awnimejri/Self-Balancing-Robot/Conception mécanique/wheel/Wheel/Wheel.JPG

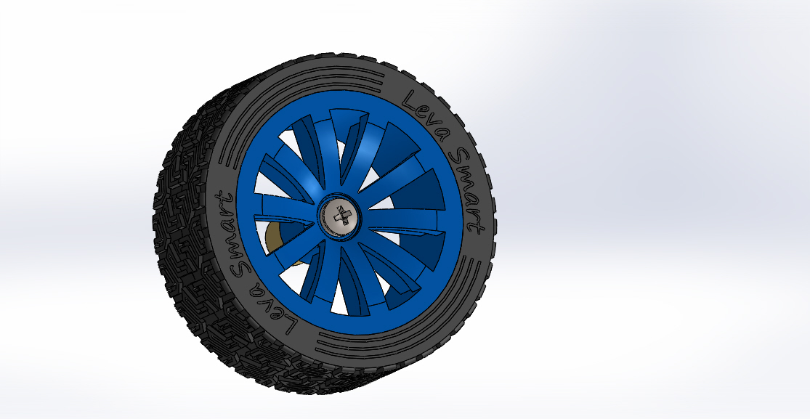
Conception mécanique/wheel/Wheel/Wheel.JPG
