awnimejri/Self-Balancing-Robot/Conception mécanique/wheel/Wheel/Tire.JPG

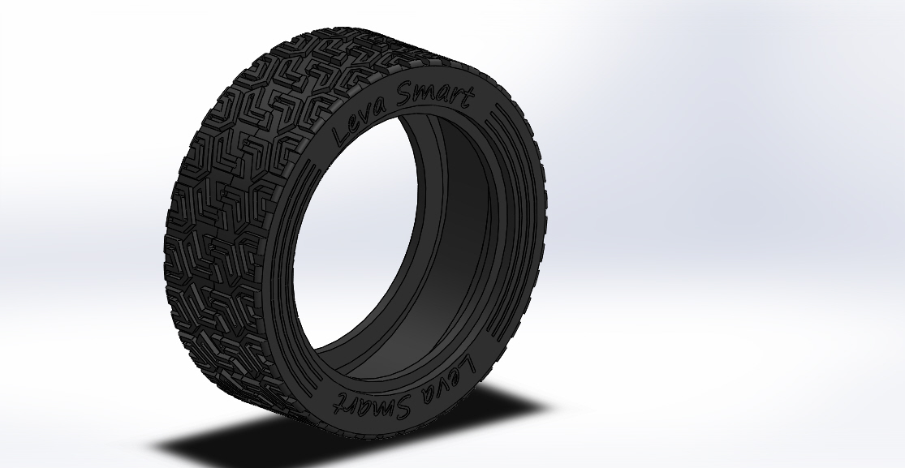
Conception mécanique/wheel/Wheel/Tire.JPG
