awnimejri/Self-Balancing-Robot/Conception électrique/pdf mirrored.pdf

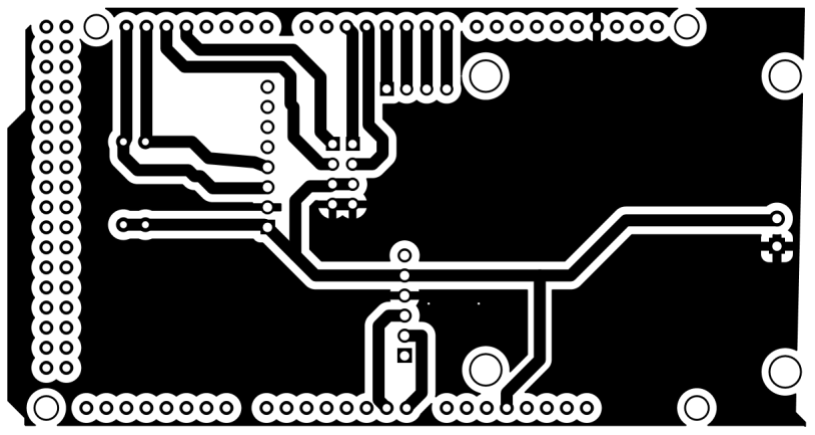
[picture p33: figure]
