awnimejri/Self-Balancing-Robot/Conception électrique/pdf.pdf

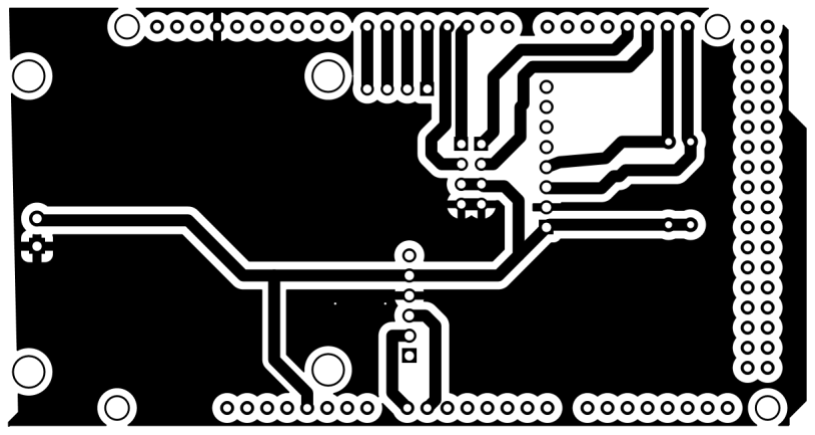
[picture p34: figure]
