awnimejri/Self-Balancing-Robot/Conception mécanique/entretoise/Hexagonal Spacer M3 MF.JPG

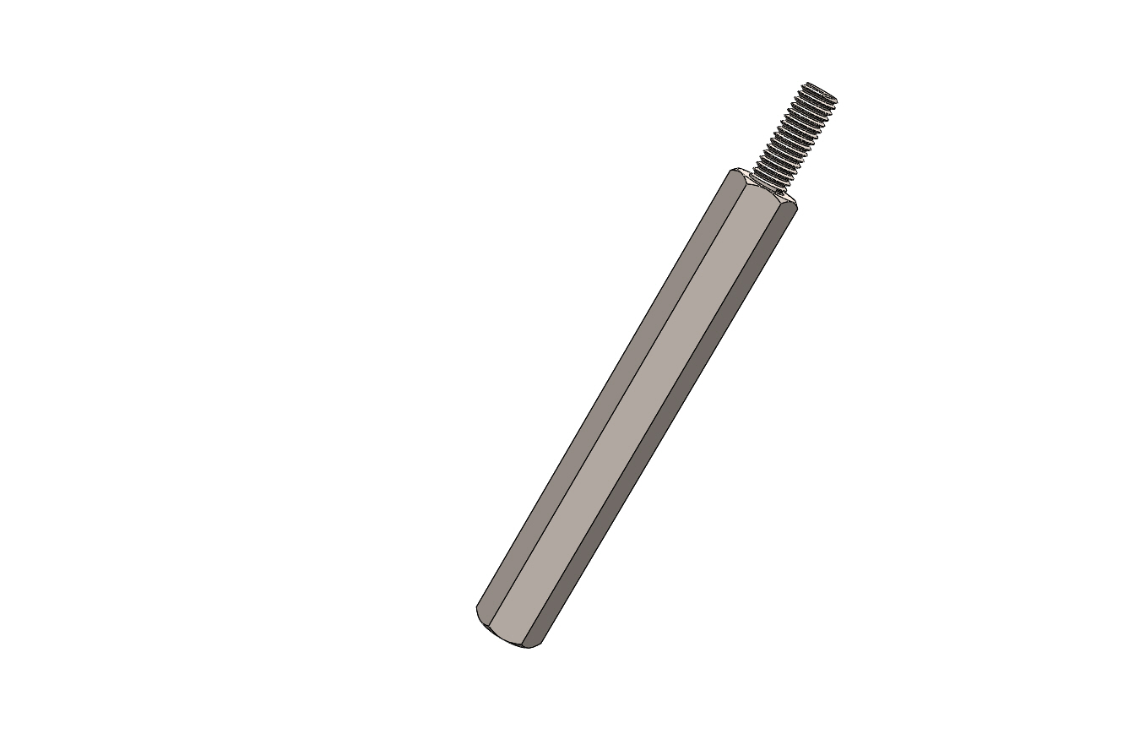
Conception mécanique/entretoise/Hexagonal Spacer M3 MF.JPG
