awnimejri/Self-Balancing-Robot/Conception mécanique/Self_balancing_robot_rendered1.JPG

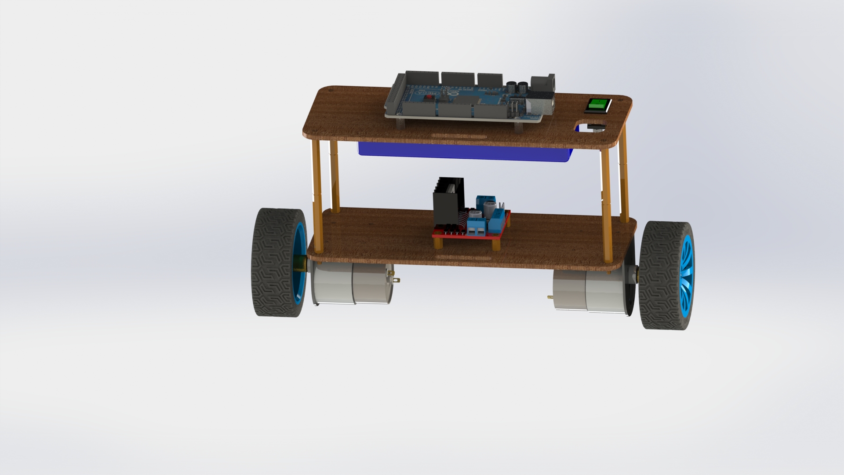
Conception mécanique/Self_balancing_robot_rendered1.JPG
