awnimejri/Self-Balancing-Robot/Conception mécanique/Self_balancing_robot_rendered2.JPG

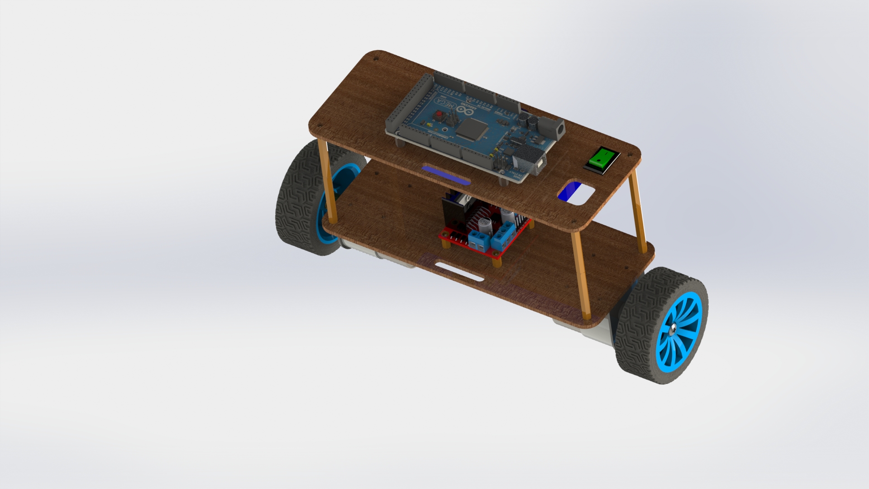
Conception mécanique/Self_balancing_robot_rendered2.JPG
