awnimejri/Self-Balancing-Robot/Conception mécanique/switch/KCD1 Switch v2 1.png

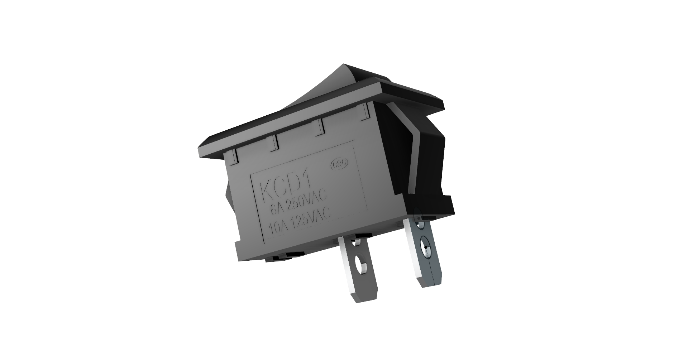
Conception mécanique/switch/KCD1 Switch v2 1.png
