awnimejri/Self-Balancing-Robot/Conception mécanique/switch/KCD1 Switch v2 2.png

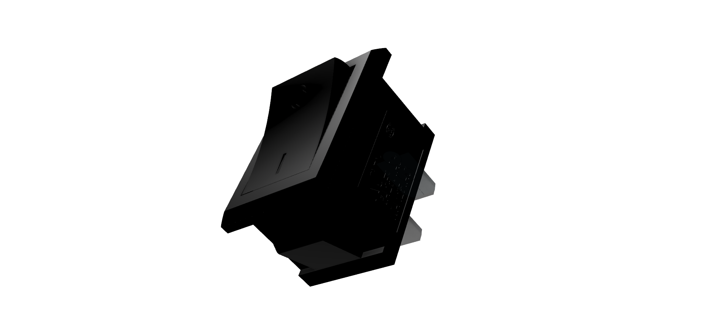
Conception mécanique/switch/KCD1 Switch v2 2.png
