awnimejri/Self-Balancing-Robot/Conception mécanique/wheel/Wheel/Rim.JPG

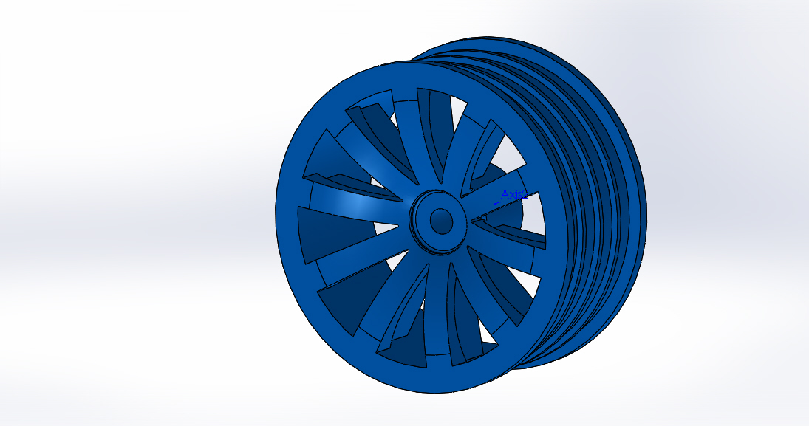
Conception mécanique/wheel/Wheel/Rim.JPG
