awnimejri/Self-Balancing-Robot/Conception électrique/3D view.PNG

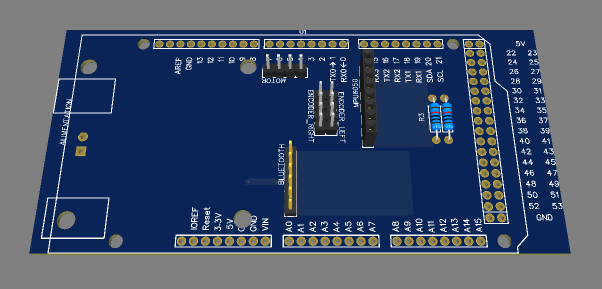
Conception électrique/3D view.PNG
