awnimejri/Self-Balancing-Robot/Conception électrique/PCB_PCB_Self_Balancing_Robot_2022-04-01.png

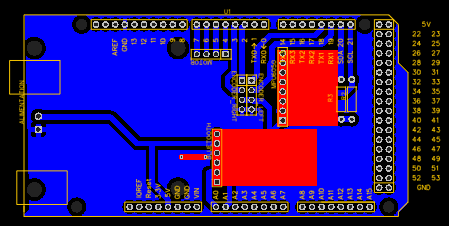
Conception électrique/PCB_PCB_Self_Balancing_Robot_2022-04-01.png
