awnimejri/Self-Balancing-Robot/Conception électrique/Schematic_Self_Balancing_Robot_2022-04-01.png

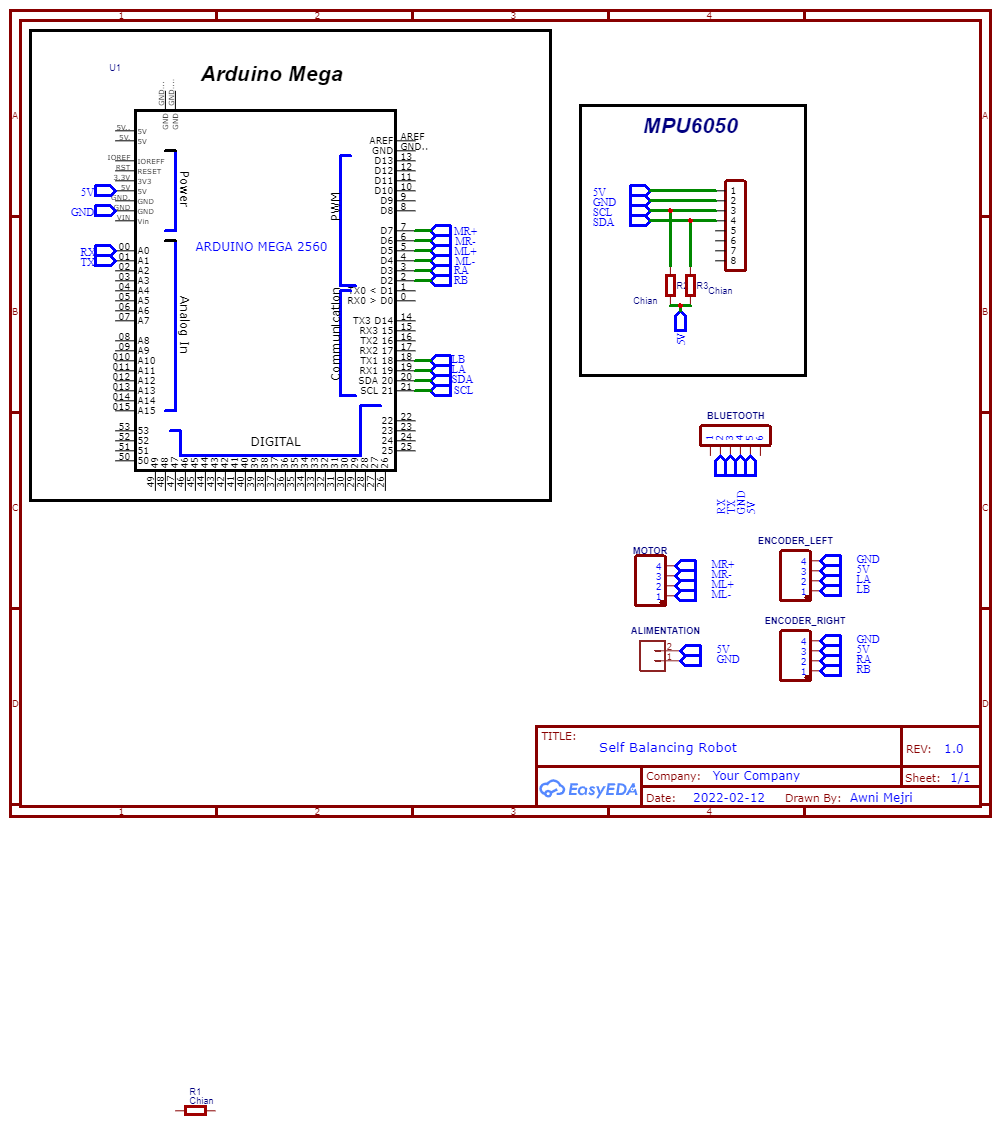
Conception électrique/Schematic_Self_Balancing_Robot_2022-04-01.png
