awnimejri/Self-Balancing-Robot/Conception mécanique/wheel/Wheel/Wheel.SLDASM

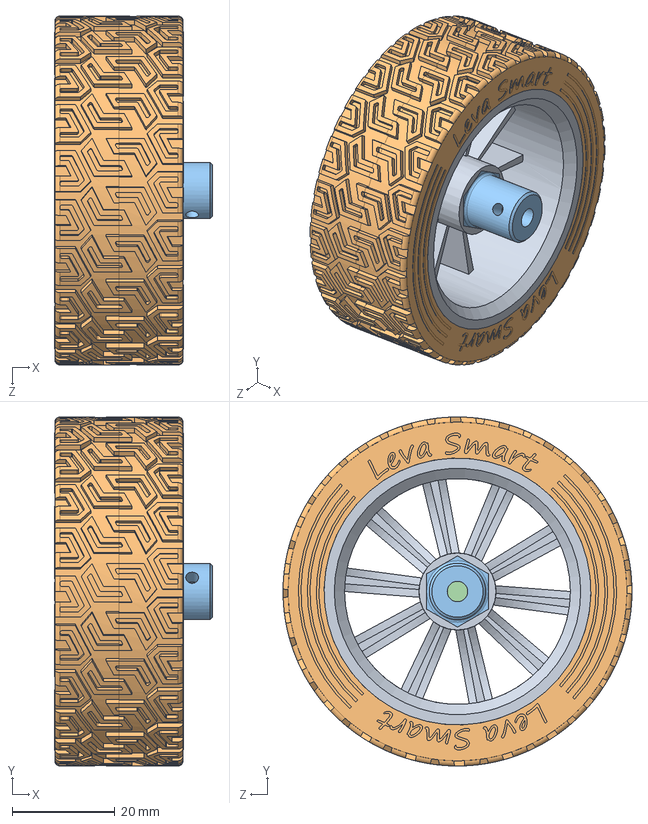
[picture p45: CAD file, 2022-04-02]
Conception mécanique/wheel/Wheel/Wheel.SLDASM
30.8 x 68.0 x 68.0 mm
Rim
Tire x 2
HexNut
pan head cross recess screw_iso
