awnimejri/Self-Balancing-Robot/Conception mécanique/wheel/Wheel/Tire.SLDASM

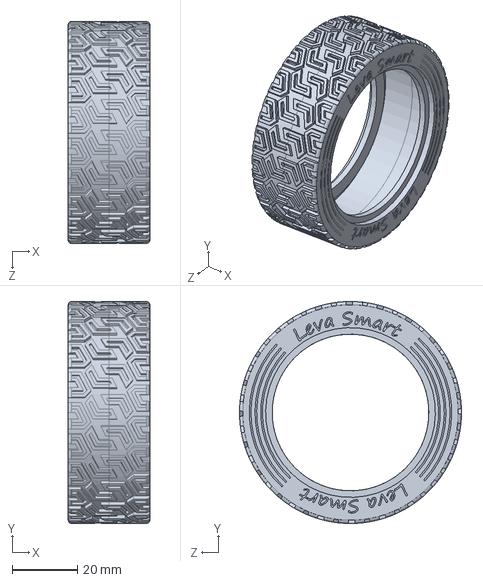
[picture p46: CAD file, 2022-04-02]
Conception mécanique/wheel/Wheel/Tire.SLDASM
25.2 x 68.0 x 68.0 mm
Tire x 2
