awnimejri/Self-Balancing-Robot/Conception mécanique/3ajla w moteur final.SLDASM

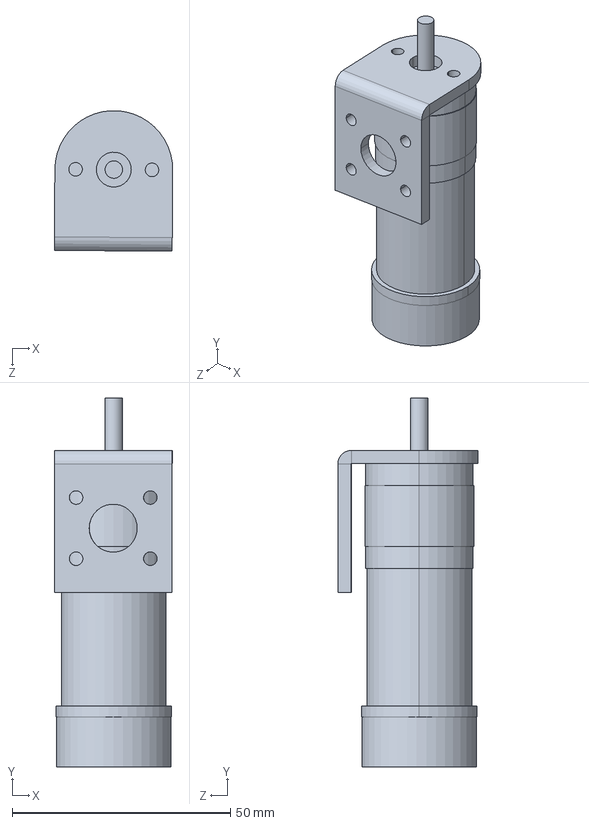
[picture p47: CAD file, 2022-03-23]
Conception mécanique/3ajla w moteur final.SLDASM
27.1 x 84.5 x 32.2 mm
