awnimejri/Self-Balancing-Robot/Conception mécanique/arduino mega/Arduino Mega 2560.SLDPRT

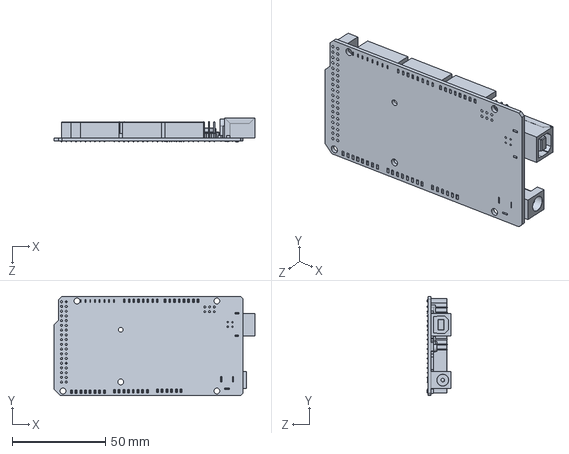
[picture p48: CAD file, 2022-03-23]
Conception mécanique/arduino mega/Arduino Mega 2560.SLDPRT
107.9 x 53.4 x 13.0 mm
