awnimejri/Self-Balancing-Robot/Conception mécanique/dc_motor/37d-gearmotor-100rpm.STEP

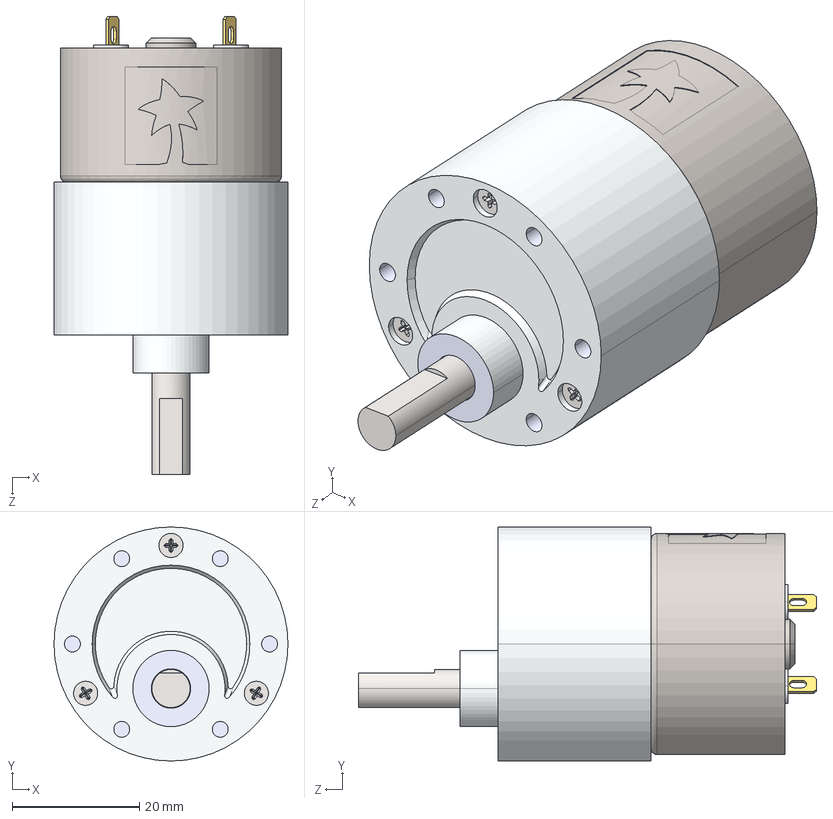
[picture p49: CAD file, 2022-04-02]
Conception mécanique/dc_motor/37d-gearmotor-100rpm.STEP
36.8 x 36.8 x 72.1 mm
