awnimejri/Self-Balancing-Robot/Conception mécanique/entretoise/Hexagonal Spacer M3 MF.SLDPRT

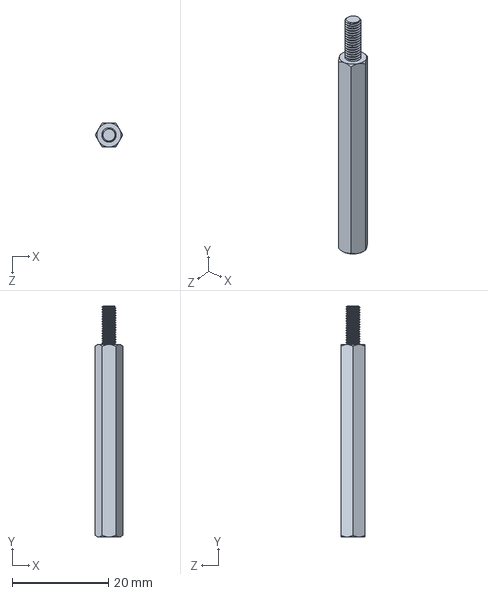
[picture p50: CAD file, 2022-04-02]
Conception mécanique/entretoise/Hexagonal Spacer M3 MF.SLDPRT
5.77 x 48.0 x 5.00 mm
