awnimejri/Self-Balancing-Robot/Conception mécanique/lipo-battery (1).sldprt

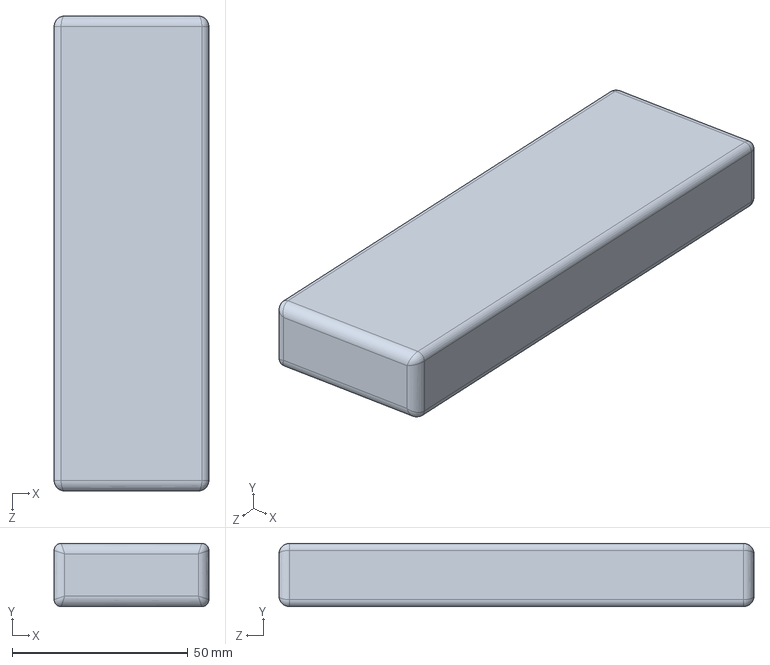
[picture p51: CAD file, 2022-04-02]
Conception mécanique/lipo-battery (1).sldprt
44.0 x 18.0 x 135.0 mm
