awnimejri/Self-Balancing-Robot/Conception mécanique/switch/KCD1 Switch v2.step

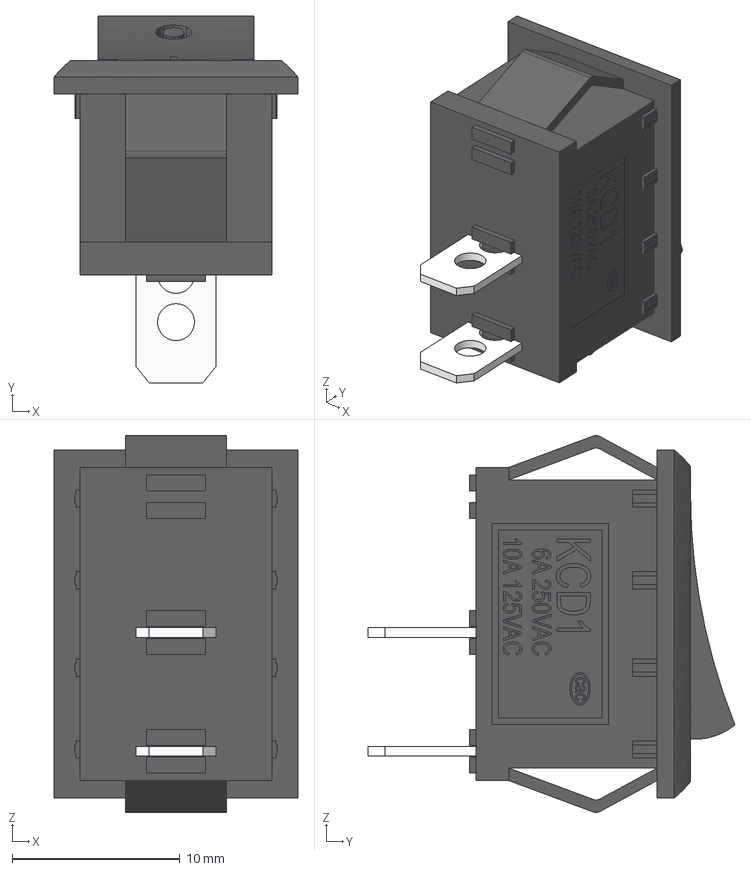
[picture p52: CAD file, 2022-04-02]
Conception mécanique/switch/KCD1 Switch v2.step
14.5 x 21.9 x 22.5 mm
