awnimejri/Self-Balancing-Robot/Conception mécanique/wheel/Wheel/HexNut.SLDPRT

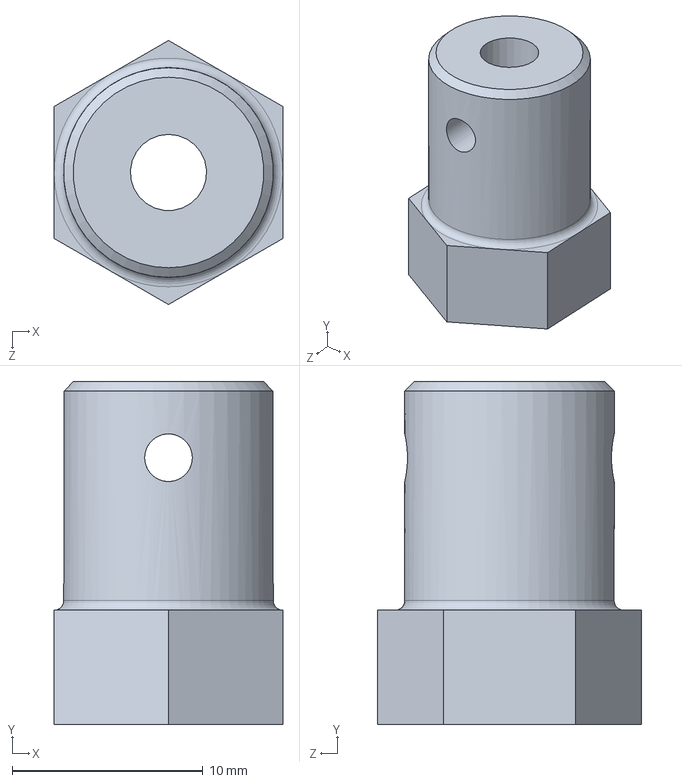
[picture p53: CAD file, 2022-04-02]
Conception mécanique/wheel/Wheel/HexNut.SLDPRT
12.0 x 18.0 x 13.9 mm
