awnimejri/Self-Balancing-Robot/Conception mécanique/base.SLDPRT

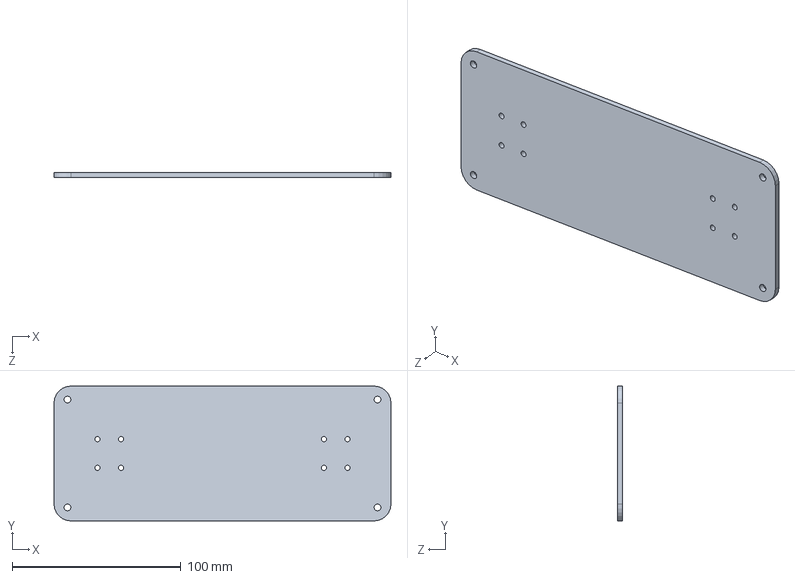
[picture p54: CAD file, 2022-04-02]
Conception mécanique/base.SLDPRT
200.0 x 80.0 x 3.00 mm
