awnimejri/Self-Balancing-Robot/Conception mécanique/dc_motor/suppor_ motor.SLDPRT

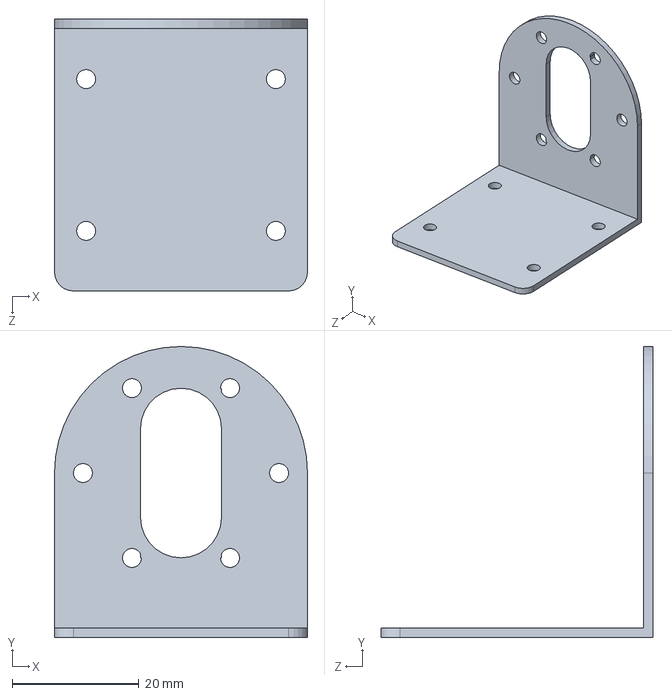
[picture p55: CAD file, 2022-04-02]
Conception mécanique/dc_motor/suppor_ motor.SLDPRT
40.0 x 46.0 x 43.0 mm
