awnimejri/Self-Balancing-Robot/Conception mécanique/entretoise/Hexagonal Spacer M3 5mm.SLDPRT

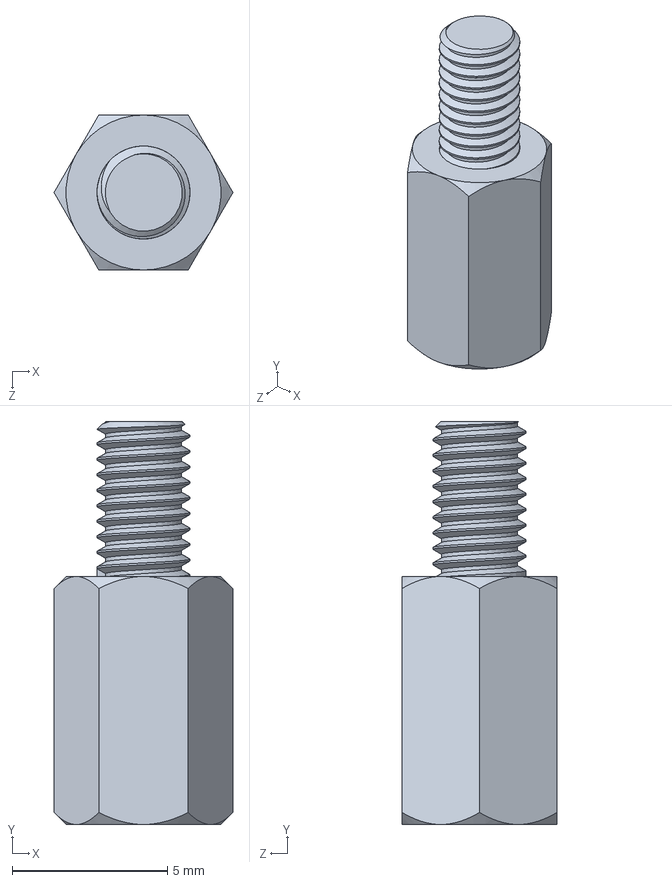
[picture p56: CAD file, 2022-04-02]
Conception mécanique/entretoise/Hexagonal Spacer M3 5mm.SLDPRT
5.77 x 13.0 x 5.00 mm
