awnimejri/Self-Balancing-Robot/Conception mécanique/étage 2.SLDPRT

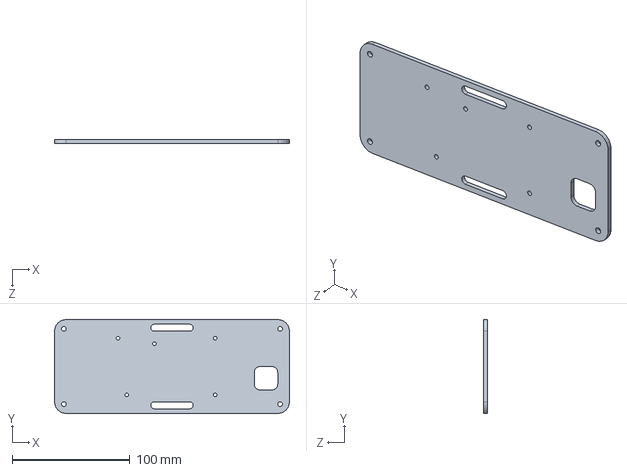
[picture p57: CAD file, 2022-04-02]
Conception mécanique/étage 2.SLDPRT
200.0 x 80.0 x 3.00 mm
