awnimejri/Self-Balancing-Robot/Conception mécanique/wheel accouplement .SLDPRT

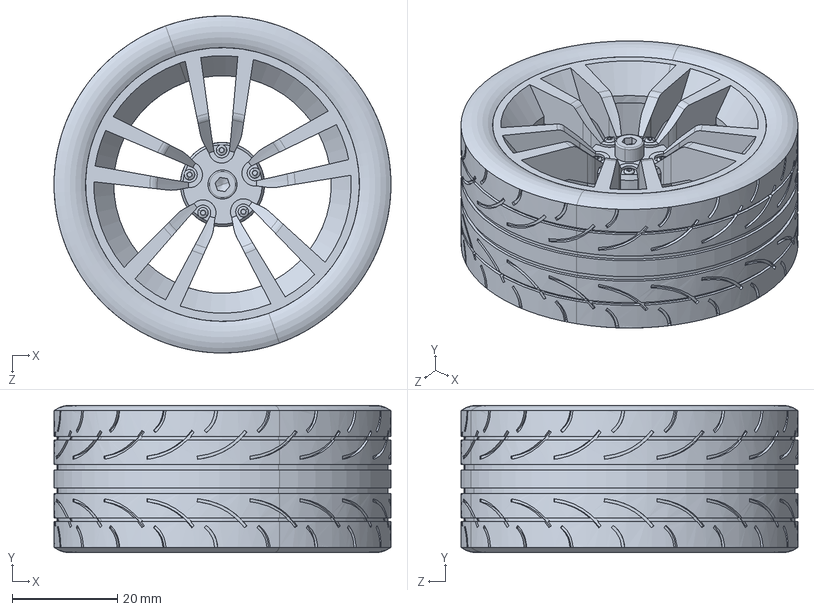
[picture p58: CAD file, 2022-03-23]
Conception mécanique/wheel accouplement .SLDPRT
64.0 x 28.0 x 64.0 mm
