awnimejri/Self-Balancing-Robot/Conception mécanique/wheel/Wheel/Rim.SLDPRT

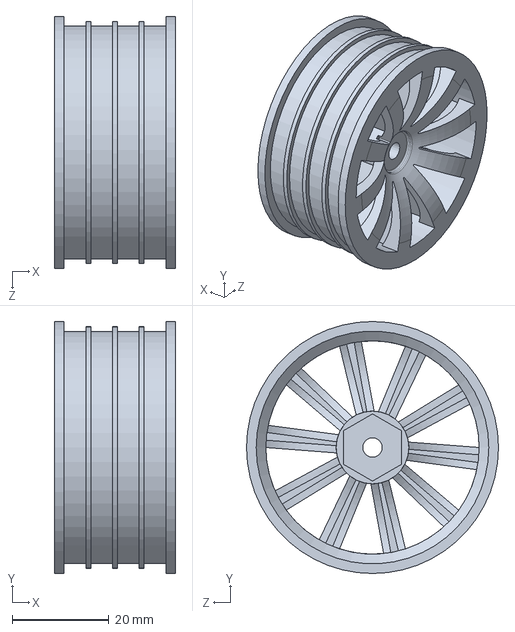
[picture p59: CAD file, 2022-04-02]
Conception mécanique/wheel/Wheel/Rim.SLDPRT
25.0 x 52.0 x 52.0 mm
