awnimejri/Self-Balancing-Robot/Conception mécanique/self balancing robot_decoupage mdf 4mm.DXF

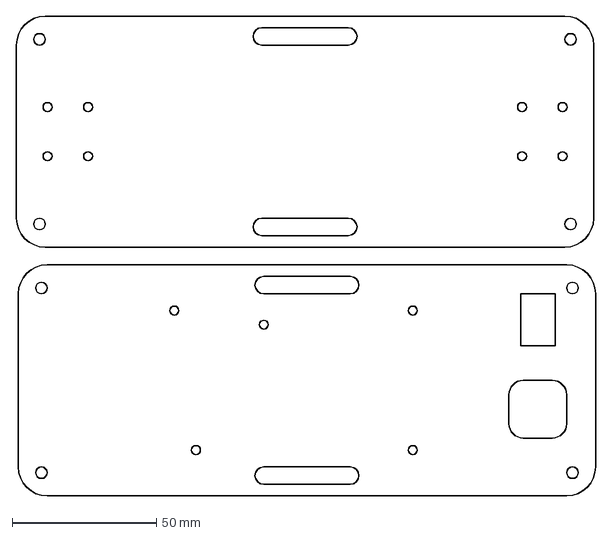
[picture p60: CAD file, 2022-03-23]
Conception mécanique/self balancing robot_decoupage mdf 4mm.DXF
200.6 x 166.2 mm
