awnimejri/Self-Balancing-Robot/(list of files, cad)

Other CAD files:
Conception mécanique/moteur w support .SLDPRT
Conception mécanique/dc_motor/37d-gearmotor-100rpm.SLDPRT
Conception mécanique/dc_motor/37d-gearmotor-100rpm.x_t
Conception mécanique/entretoise/Hexagonal Spacer M3 MF.IGS
Conception mécanique/switch/KCD1 Switch v2.3mf
Conception mécanique/switch/KCD1 Switch v2.obj
Conception mécanique/switch/KCD1 Switch v2.skp
Conception mécanique/wheel/Wheel/Tire.SLDPRT
