awnimejri/Self-Balancing-Robot/code/LMotorController.h

#ifndef LMotorController_h
#define LMotorController_h


#include "Arduino.h"


class LMotorController
{
protected:
    int _ena, _in1, _in2, _enb, _in3, _in4;
    int _currentSpeed;
    double _motorAConst, _motorBConst;
public:
    LMotorController(int in1, int in2, int in3, int in4, double motorAConst, double motorBConst);
    void move(int leftSpeed, int rightSpeed, int minAbsSpeed);
    void move(int speed);
    void move(int speed, int minAbsSpeed);
    void turnLeft(int speed, bool kick);
    void turnRight(int speed, bool kick);
    void stopMoving();
};


#endif
